cliffgraph/XIOTHIEF/pics/no.JPG

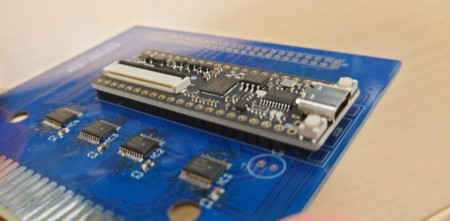
pics/no.JPG
