cliffgraph/XIOTHIEF/pics/pins.JPG

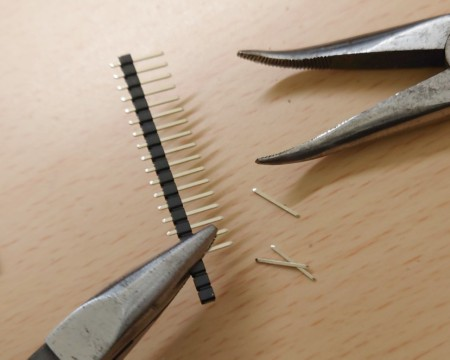
pics/pins.JPG
