cliffgraph/XIOTHIEF/pics/shell_cable.JPG

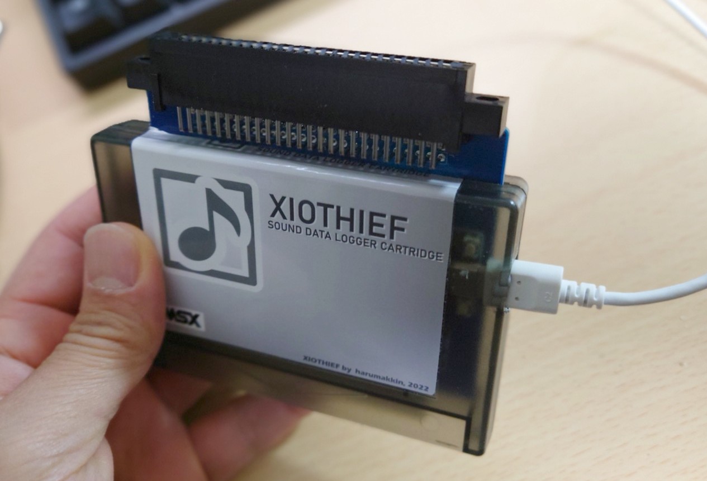
pics/shell_cable.JPG
