cliffgraph/XIOTHIEF/pics/shell_ng.JPG

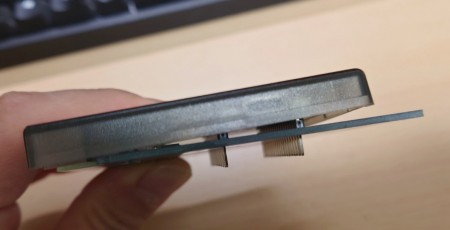
pics/shell_ng.JPG
