cliffgraph/XIOTHIEF/pics/shell_ok.JPG

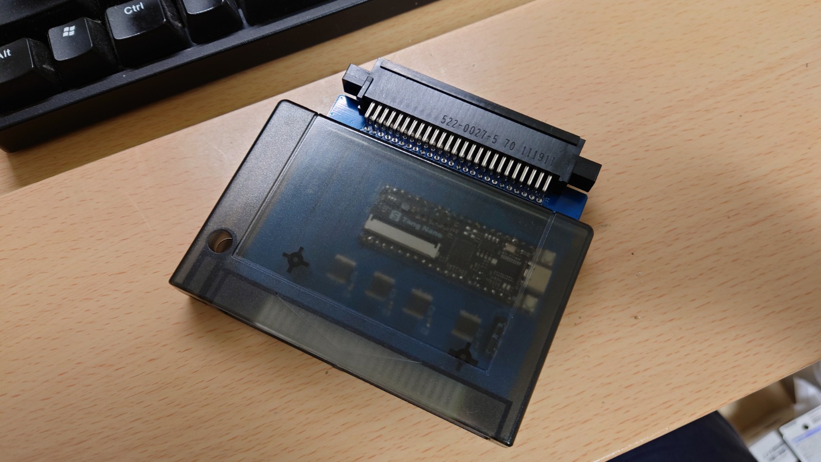
pics/shell_ok.JPG
