cliffgraph/XIOTHIEF/pcb/XIOTHIEF-01B_部品表.pdf

XIOTHIEF-02A
記号 | 型番 | 個数 | 部品スペック、他 | 購入元
IC1～IC4 | SN74LVC245APWR | 4 | IC TXRX NON-INVERT 3.6V 20TSSOP【SN74LVC245APWR】 | マルツオンライン | | https://www.marutsu.co.jp/pc/i/27579501/
C1～C4 | GRM188F11H104ZA01 | 4 | チップ積層セラミックコンデンサー　０．１μＦ５０Ｖ　Ｆ　１６０８　（４０個入） | 秋月電子 | P-13374 | https://akizukidenshi.com/catalog/g/gP-13374/
C5 | 1AUTES101M0 | 1 | 電解コンデンサ 10V 100μF　（１０個） | 千石電商 | | https://www.sengoku.co.jp/mod/sgk_cart/detail.php?code=76S8-53LK
U1 | TangoNano | 1 | Sipeed Tang Nano FPGAボード GW1N-1 FPGAチップ搭載 | seeed studio | | https://jp.seeedstudio.com/Sipeed-Tang-Nano-FPGA-board-powered-by-GW1N-1-FPGA-p-4304.html
J1 | CR22-50D-2.54DSA(70) | 1 | 50P カードエッジコネクタ　ライトアングル | マルツオンライン | | https://www.marutsu.co.jp/GoodsDetail.jsp?q=CR22-50D-2.54DSA%2870%29&salesGoodsCode=12064841&shopNo=3
