cliffgraph/XIOTHIEF/pcb/XIOTHIEF-02A_schematic.pdf

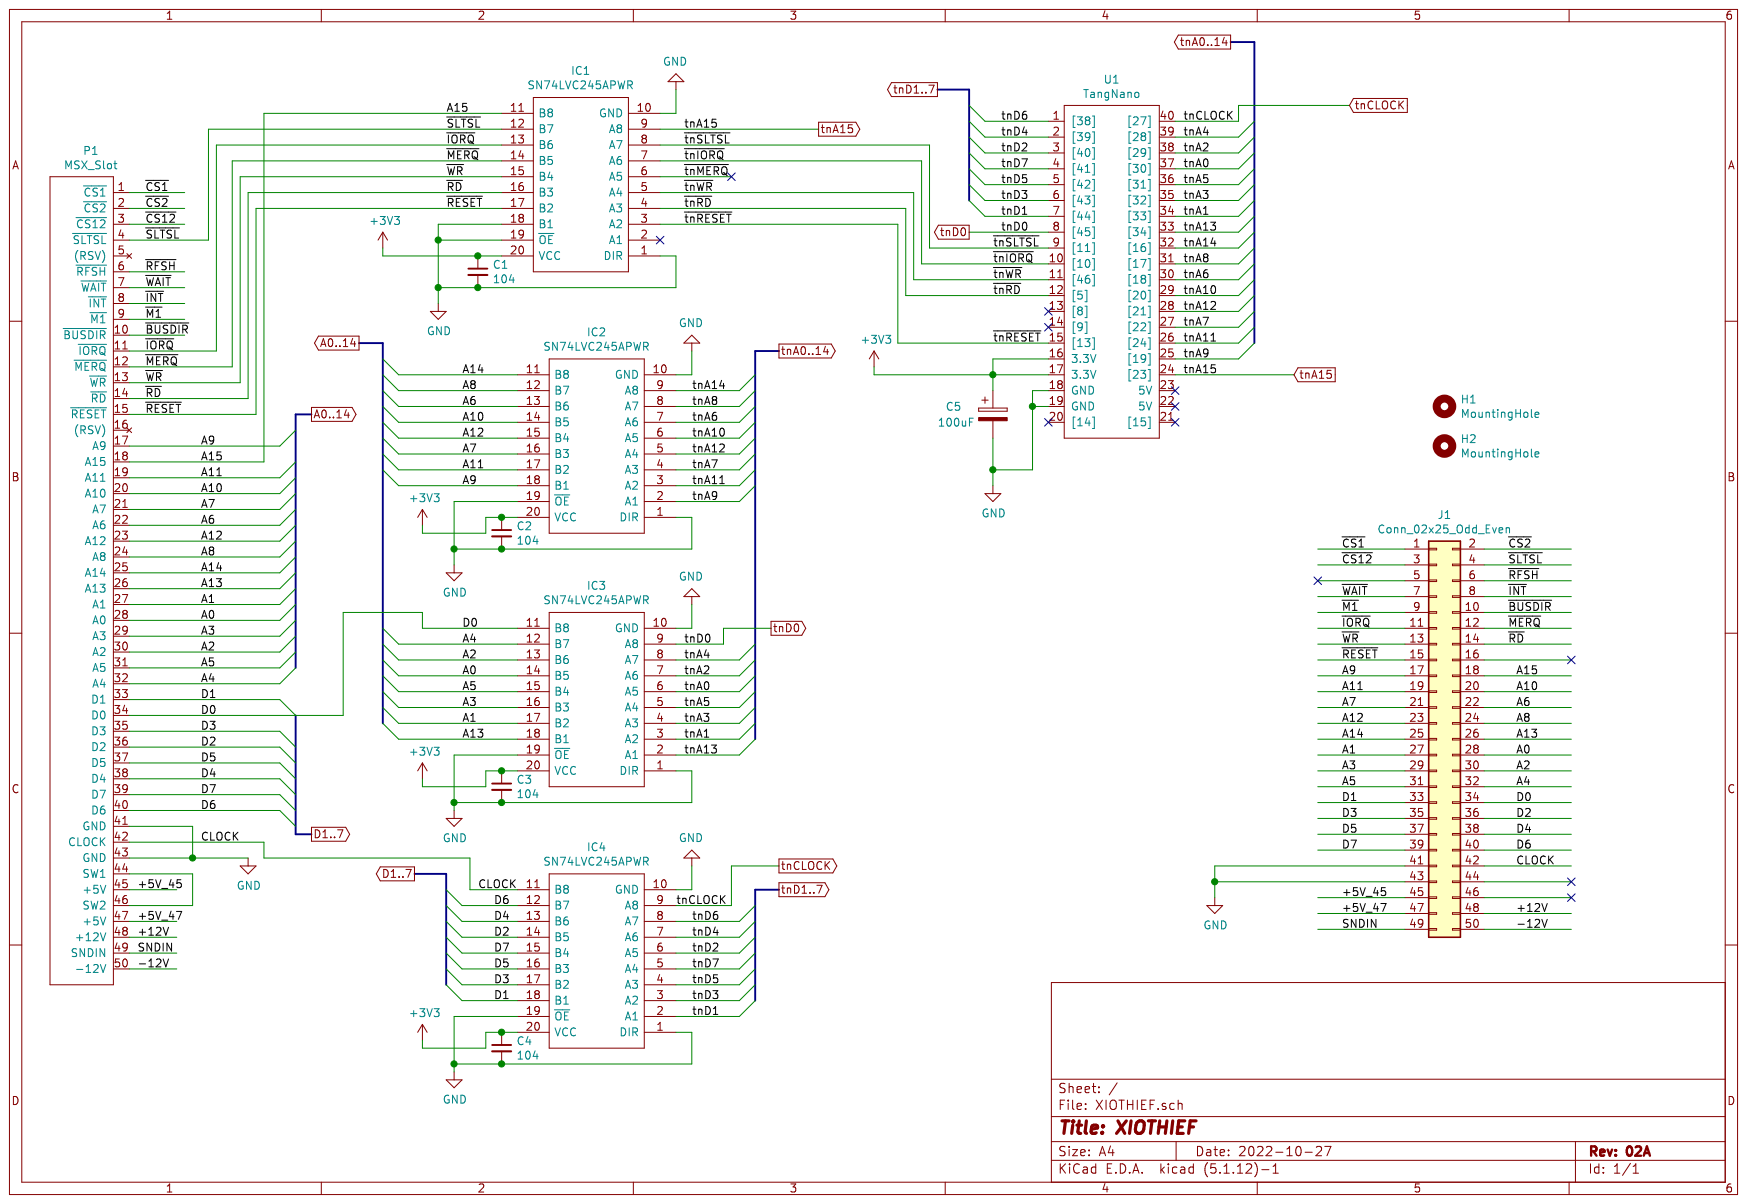
[picture p8: page 1]
