cliffgraph/XIOTHIEF/tangnano/src/gowin_osc/gowin_osc_tmp.v

//Copyright (C)2014-2022 Gowin Semiconductor Corporation.
//All rights reserved.
//File Title: Template file for instantiation
//GOWIN Version: V1.9.8.08
//Part Number: GW1N-LV1QN48C6/I5
//Device: GW1N-1
//Created Time: Mon Oct 10 00:12:58 2022

//Change the instance name and port connections to the signal names
//--------Copy here to design--------

    Gowin_OSC your_instance_name(
        .oscout(oscout_o) //output oscout
    );

//--------Copy end-------------------
